YosubShin/head-cam-umi/paper/README.md

# A Head Camera Is (Almost) All You Need — paper sources

Reader's guide for the paper (`main.tex`, built `main.pdf`), as submitted to arXiv
([arXiv:2610.27622](https://arxiv.org/abs/2610.27622), October 2026) and to the CoRL 2026 workshop "The UMI Arena" (Track 3 contributed papers, 2-4 pages excluding
references, CoRL format). The submitted state is tagged `arxiv-v1-submission` in the
[yam-umi](https://github.com/YosubShin/yam-umi) repository, where the draft was written.

Build: `latexmk -pdf main.tex` in this directory (then `latexmk -c`). Layout: `sections/` are the 4-page
versions, `sections/appendix.tex` follows the references, `sections/full/` holds the pre-cut text.
Figure scripts in `fig/` read `../../rollout_logs/grid_20261016/` and `../../docs/results/` of this
repository; `fig/grid_stats.py` reproduces every rollout number in the text.

## The system in five lines

1. The glove is the fiducial-tracked YAM gripper replica from the YAM-UMI paper ([yam-umi/paper](https://github.com/YosubShin/yam-umi/tree/main/paper)).
2. The collector wears one 4K camera. It sees the fiducial ball on the glove, the jaw tags, and
   four printed AprilTag tiles taped around the workspace. Every frame gives camera pose (tiles),
   gripper pose (ball) and jaw width (tags) from that one image. No fixed camera, no IMU, no SLAM.
3. On the robot a six-joint SO-101 arm carries the same camera and keeps the gripper in view the
   way the collector's head kept the hand in view, from the robot's joint state alone. Teleop data
   and rollouts both go through it, so training and deployment share one viewpoint distribution.
4. A fixed external camera exists in the rig only as an ablation (it is how the device-track paper
   labelled the glove).
5. Policies are ACT, one recipe, joint-space actions, best checkpoint by validation loss on 6
   held-out teleoperated episodes.

## The eight policies on the robot

Every arm's teleop half carries the robot's encoder labels; only the glove half carries the
camera under test. Same 198 glove demonstrations in every mix. "val" = ACT loss on the 6
held-out teleoperated episodes, encoder targets, comparable across all rows.

| # | arm (code name) | what it is | glove labels | policy camera | training data | val |
|---|---|---|---|---|---|---|
| 1 | head_Hgt | teleop only, full budget | - | head cam | 172 teleop | 0.318 |
| 2 | mix_gHs3 | **the device** | head cam | head cam | 172 teleop + 194 glove segments | **0.263** |
| 3 | head_Hgt48 | teleop only, low budget | - | head cam | 48 teleop | 0.464 |
| 4 | mix_gHs3_48 | device, low budget | head cam | head cam | 48 teleop + 194 glove | 0.295 |
| 5 | mix_FA | conventional wrist-cam UMI | fixed cam | wrist fisheye | 168 teleop + 253 glove | 0.257 |
| 6 | head_HH | teleop labelled by the head cam, no encoders | - | head cam | 172 teleop | 0.328 |
| 7 | mix_FB | fixed camera as the whole system | fixed cam | fixed cam | 172 teleop + 255 glove | 0.256 |
| 8 | mix_gHA | head labels on the wrist view | head cam | wrist fisheye | 168 teleop + 192 glove | 0.252 |

Notes. Arms 5 and 8 have 168 teleop episodes because the wrist recording has gaps in four.
Arms 5 and 7 have more glove *segments* but 10% fewer glove *frames* (43.5k vs 48.5k): the fixed
camera loses the gripper behind the collector's body, those stretches are cut, and the episodes
fragment. Arm 6 is scored on the encoder targets too (its own-chain loss is 0.282).

## Final rollout tally (25 scenes, 200 trials, done 21:40 on 16 Oct; `fig/grid_stats.py` recomputes)

Protocol: 25 block placements, each placed once and then re-placed to a saved reference image
(ghost alignment) for every other arm; arm order shuffled per scene; 60 s budget; outcome scored
by the operator (success / no grasp / dropped before bin / dropped at bin / timeout).
Log: `rollout_logs/grid_20261016/trials.jsonl`; policy-view mp4 per trial, external-view
`_world.mp4` from scene 15 on.

| # | arm | success | median time to success | failures |
|---|---|---|---|---|
| 1 | teleop only 172 | 18/25 | 16.1 s | 5 no-grasp, 1 dropped before bin (scene 22, slip right after lift), 1 timeout |
| 2 | **device** 172 + glove | **20/25** | 17.4 s | 5 no-grasp |
| 3 | teleop only 48 | 10/25 | 17.2 s | 15 no-grasp |
| 4 | device 48 + glove | 17/25 | 17.2 s | 8 no-grasp |
| 5 | wrist-cam UMI | 15/25 | 18.1 s | 6 no-grasp, 3 dropped before bin, 1 at bin |
| 6 | head-cam teleop labels | 15/25 | 18.7 s | 10 no-grasp |
| 7 | fixed camera system | 12/25 | 18.5 s | 12 no-grasp, 1 dropped at bin |
| 8 | head labels, wrist view | 14/25 | 15.6 s | 3 no-grasp, 7 dropped before bin, 1 at bin |

Paired (same scenes) exact McNemar tests, wins / losses / two-sided p:

| comparison | wins / losses | p |
|---|---|---|
| device 48 vs teleop-only 48 (arm 4 vs 3) | 9 / 2 | 0.065 |
| teleop-only 172 vs 48 (1 vs 3) | 11 / 3 | 0.057 |
| device vs teleop-only, full budget (2 vs 1) | 4 / 2 | 0.69 |
| device 48 vs teleop-only 172 (4 vs 1) | 4 / 5 | 1.0 |
| head labels vs encoders (6 vs 1) | 5 / 8 | 0.58 |
| device vs wrist-cam UMI (2 vs 5) | 6 / 1 | 0.125 |
| device vs fixed camera (2 vs 7) | 11 / 3 | 0.057 |
| device vs head labels on wrist view (2 vs 8) | 8 / 2 | 0.11 |
| label source on the wrist view (8 vs 5) | 2 / 3 | 1.0 |
| wrist vs fixed (5 vs 7) | 9 / 6 | 0.61 |

Drops (before or at bin): wrist-view arms 5+8: 12 of 21 failures; head-view arms 1-4, 6: 1 of 45;
fixed camera: 1 of 13.

Resolution: at 25 trials the binomial 95% interval is about +/-18 points. No pair clears p = 0.05;
the two at 0.06 (budget pair, device vs fixed camera) were at 0.07 with 19 scenes and the wrist pair
went from 6/0 (p = 0.03) to 6/1 (p = 0.125) when arm 5 won scene 24. The paper says so in the
limitations and leans on the consistency of the ranking (arm 2 loses to no arm on more than three
placements) rather than on any one p.

## The one-line story

The provocative version: a head camera is all a UMI needs. The defensible version: one egocentric
moving camera replaces the wrist camera *and* the pose tracker (SLAM, IMU, VR controller, fixed
base camera), and the policy is as good. What it buys: no electronics in the glove at all, since
fiducials give pose and jaw width from the head cam's view. What it costs: a moving camera at
deployment. The mitigation: a cheap servo-driven printed camera arm (SO-101 follower, about $120 in parts; glove $22, camera $122) was shown to work, and its
viewpoint model is a naive linear fit on one glove session, so the numbers here are a floor.

## The stories, in the order the paper tells them

1. **One worn camera labels the glove in the wild.** Tiles replace the fixed camera as the world
   frame; single-tile frames are chained; blind stretches are cut rather than losing the episode.
   Numbers (final): 0.7-7.4% of frames cut per session vs 8-22% for the fixed camera; tool-point
   label error vs the robot's encoders 6.5 mm median / 14.1 mm p90, 1.55 deg; a policy trained on
   head-cam labels instead of encoders pays 3% in validation loss (0.328 vs 0.318), where the
   fixed-camera glove paid 14% in the device paper.
2. **Glove data stretches a small teleop budget.** Offline: the 194 glove segments are worth
   65-100 teleop episodes (2-3 glove demos per teleop demo); 48 teleop + glove lands between 96
   and 172 teleop alone. Robot (final, 25 scenes): 10/25 -> 17/25 at the 48 budget (9 wins / 2 losses, p = 0.065),
   level with the full 172-episode teleop-only arm (18/25); every failure of both 48-episode arms a no-grasp. The gain shrinks with budget: at full budget the device and teleop-only are
   tied (20/25 vs 18/25), which is the task ceiling (about 80%), not a failure of the glove data.
3. **The same camera on the robot closes the viewpoint gap.** Teleop and rollouts see what the
   collector saw. The positioner is driven from joint state only, identically in both.
4. **Which camera, and why.** Offline all four co-trained arms (2, 5, 7, 8) are within 0.011, so
   the loss does not separate cameras. On the robot the failure modes do: head-view arms fail
   by never grasping (43 of 45 failures; one slip right after lift, one timeout); wrist-view arms
   drop the block during the carry (12 of 21), and every observed wrist drop happened while the
   bin was outside the fisheye's view. Arm 8 vs 2 isolates the observation
   (same labels); arm 8 vs 5 isolates the label source (same observation); arm 7 asks whether a
   moving camera is needed at all.

## What the paper now claims (25 scenes, all filled in; `\grid` renders black now)

- Glove data recovers the low-budget teleop policy (arm 4 vs 3: 17/25 vs 10/25, 9 wins to 2,
  p = 0.065) and lands it level with the full-budget teleop-only arm (18/25). Headline robot
  result; matches the offline curve. Written as "outperforming ... matching".
- At full budget co-training does no harm (arm 2 vs 1: 20/25 vs 18/25, 4/2). Task ceiling about
  80%.
- The camera matters, the labels do not. Device 20/25 vs wrist 15/25, fixed 12/25, head labels on
  wrist 14/25 (6/1, 11/3, 8/2 wins). Same labels, wrist view (8 vs 2): loses six placements and
  the no-grasps become drops. Same view, other labels (8 vs 5): 14 vs 15, 2/3, indistinguishable.
- Failure modes split by camera: 12 of 21 wrist-view failures are drops; 1 of 45 head-view
  failures (a slip, not a release); the fixed camera fails like the head view (no grasp) but more
  often.
- Head-camera labels in place of encoders: 15/25 vs 18/25, 5 wins to 8, p = 0.58. Written as
  "within the noise of 25 trials", not "as good as".
- Honesty line in the limitations: single seed, one trial per placement, no pair below 0.05, two
  at 0.06, ranking consistent.

## What is still open in the text

- Teaser figure: done (`fig/make_teaser.py`; sources `fig/src/collector_iphone_26s.jpg`, `rollout_iphone_250s.jpg`,
  `headcam_glove6_182s_overlay.jpg`). The iPhone videos they come from are in `media/originals/` (gitignored)
  and on the NAS at `yam-umi-media/originals/`; the rollout one (8 min, all arms on one scene) is supplementary-video material.
- Two `\todo{confirm}` in limitations (one collector; remote-workspace calibration), how the camera
  is worn (system), which hand-eye solver (system), keep-or-cut on fig:rollouts.
- Length: cut to 4 pages of body at 22:50 on 16 Oct (references on p.5, appendix A-C with the budget curve,
  placements map and rollout strip on p.7-8). The full-length sections are kept in `sections/full/` for
  reference and for the camera-ready; nothing was deleted, only moved to the appendix or condensed.

## Caveats to keep in the text

- The fixed camera was mounted low because the positioner occupied the high vantage point; its
  occlusion rate (8-22%) is an upper bound for a fixed camera in this workspace. Arm 8 is the
  control that does not depend on the mount height.
- Tile layout was refit from one session by median single-tile poses, not bundle-adjusted.
- Positioner lag about 0.4 s; joint limits on the largest sweeps.
- Appearance gap: the head cam sees the collector's arm and the glove's fingers; glove-only
  policies do not transfer (val 0.52 vs 0.26 co-trained), as in the device paper.
- 25 trials per arm; one seed per policy; no paired difference below p = 0.05 (two at 0.06).

## Anecdotes (operator notes, `rollout_logs/grid_20261016/anecdotes.md`)

- Scene 5, low budget: teleop-only could not close in on the block; the mix missed its first
  grasp, backed off, re-grasped and succeeded.
- Scene 5, arm 8: opened the gripper mid-carry with the block out of the wrist camera's view.
- Wrist-view arms drop when the wrist view is looking away from the bin; the converse was never
  seen.

## Feedback received so far

**Yuan (16 Oct, after reading the draft and setting up collection on a Mac).**

1. *Jaw-width accuracy deserves its own check.* Their fixed-camera width estimator read a
   59.1 mm opening with 0.29 mm p95 error in one view but 2.3 and 5.1 mm in two turned poses.
   Done: a width sentence in the label-accuracy paragraph, from the 112 teleoperated episodes
   where encoders are the reference (3.5% of stroke median, 7.9% p90, 2.3% when closed, no lag,
   100% coverage in 9 of 10 episodes, a 4-6% under-read at full opening). Also binned by workspace quartile, distance, camera elevation and
   line-of-sight angle to the jaws (forward kinematics on the encoder joints): every bin 2.8-4.8%
   median, 6.8-8.5% p90, worst looking across the jaws. The fixed camera of the device paper read
   the same gripper at 4.4% median, 94% coverage. What this does not cover: openings never seen in
   calibration (the teleop estimators are fit on alternate frames of the same session; the glove's
   are fit on spacer holds in one session and applied to the other three, unmeasured).
2. *Tile placement and visibility.* Clips where the head cam tracked the glove but got no world
   pose; a tag PDF open on a laptop confused localisation. Done: two practical rules in the
   collection paragraph (tiles where the gaze lands at the grasp, two in view from the natural head
   pose, none under the bin or in the arm's sweep; no other tag in the scene).

**Yosub.** The tail was not explained; it is now (collection paragraph). It is the part that makes
an electronics-free glove possible: fingertip tags face the wrist camera and are invisible from
behind the hand (0 of 13.7k frames in the first test, Aug 2026), so each jaw carries a wedge with
tags on five faces, read against a fixed tag on the gripper back. The original feasibility
numbers (robot gripper, fixed camera, Aug-Sep 2026): single-tail fallback 5-7 mm RMS over the
95 mm swing; later wedges with more faces, 94% coverage and 4.4% of stroke median error.

## Confound to keep in mind (not in the paper)

Between last week's rollouts and this grid the glove width map changed (closed-on-object anchor
0.246 -> 0.225, the squeeze level). Last week's mid-air drops, including the wrist and fixed-cam
arms, cannot be attributed to the camera because of that; this grid is clean (all eight arms use
the new map), and within it the head-view arms have not dropped once. Grasp tuning is necessary
regardless of camera.

## Hypothesis to keep in view: the teleoperation style is the head view's

All eight arms train on the same 172 teleoperated episodes, recorded by the head, wrist and fixed
cameras at once, so the actions are identical across arms and only the observation differs. Those
actions were chosen by an operator watching the head camera's preview. Nothing in them keeps the
bin inside the fisheye's view during the carry, or keeps the gripper clear of the robot's own upper
arm for the low fixed camera. Rollout frames (scene 12) show exactly that: from the grasp onward
the wrist view holds the block and the far wall and nothing else, the bin appearing only at the
end; the head view holds bin, gripper and block throughout; the fixed view loses the gripper behind
the upper arm. Every policy inherits the style, and the two cameras that do not share the
operator's view pay at those moments (wrist: drops; fixed: no-grasp from occlusion).

This is also the normal UMI condition, since a human demonstrator sees the scene while the wrist
camera sees a cone, so it is a property of the method rather than a handicap we introduced. The
defensible claim is "the camera that shares the demonstrator's view wins".

The two sentences are in the text (design paragraph; limitations).

Future work, actual experiments:

- With existing data: over the carry phase of the 172 teleoperated episodes, the fraction of
  frames in which the bin is inside each camera's view (large grey-blue region, area threshold
  separates it from the small blue blocks), from the three synchronized streams.
- New collection: a teleop set recorded under a wrist-camera preview (and one under the fixed
  camera's), same episode budget, then arms 5 and 7 retrained on it. This separates "better
  camera" from "camera that matches the demonstrator".

## Where help is wanted (Igor)

- Citations and one or two background sentences in Section 1: SLAM/IMU tracking in UMI-style
  devices vs fiducial or marker-based localisation; prior work that moves a robot-side camera to
  match a human viewpoint (active perception, head-mounted or arm-mounted cameras); the
  egocentric viewpoint gap literature. No related-work section is planned; clauses in place.
- Tone of the limitations paragraph and the "what is next" sentence.
- Anything in the system section that is unclear to a reader who has not seen the rig.
- The red `\todo` items: how the camera is worn (mount, weight), teaser figure, placements figure.

Repository layout: `main.tex` (preamble, title, teaser figure, bibliography) pulls in one file per
section from `sections/` (`abstract`, `idea`, `system`, `experiments`, `limitations`), so edit the
text there. `resources/venue.md` records the venue rules and dates. `refs.bib` (shared with the
device paper), `fig/make_budget.py`
regenerates `fig/budget.pdf` from `../docs/results/head_val_curves.csv`. The YAM-UMI paper (yam-umi/paper) is
the reference for style and length.
