YosubShin/head-cam-umi/paper/main.tex

\documentclass{article}

% CoRL 2026 workshop "The UMI Arena", Track 3 (contributed papers): 2-4 pages EXCLUDING acknowledgements
% and references, CoRL main-conference format, single-blind, OpenReview. Topics hit: in-the-wild tracking
% beyond SLAM; the egocentric viewpoint gap between collection and deployment; data scaling/curation.
% Full venue rules and dates: resources/venue.md. Body text lives in sections/*.tex.
\usepackage[preprint]{corl_2026}
\usepackage{graphicx}
\usepackage{booktabs}
\usepackage{xcolor}
\usepackage{siunitx}
\usepackage{multirow}
\newcommand{\todo}[1]{\textcolor{red}{[#1]}}
\newcommand{\grid}[1]{#1}   % numbers from the 2026-10-16 rollout grid (final, 25 scenes; fig/grid_stats.py). Was blue while unfilled.

\title{A Head Camera Is (Almost) All You Need:\\An Electronics-Free UMI Glove Labelled and Observed by One Moving Camera}

\author{
  Yosub Shin \\
  University of Hawaii at Manoa \\
  \texttt{yosubs@hawaii.edu} \\
  \And
  Yuan Liu \\
  Independent \\
  \texttt{hiveyuan@gmail.com} \\
  \And
  Igor Molybog \\
  University of Hawaii at Manoa \\
  \texttt{molybog@hawaii.edu} \\
}

\begin{document}
\maketitle

%===============================================================================
\input{sections/abstract}

\begin{figure}[!h]
  \centering
  
  \caption{One camera, two mounts. (a) The collector wears the camera and holds the electronics-free glove over the tiled workspace. (b) The camera's own frame: tiles (green), ball (red) and jaw tags (blue, yellow) give the pose and the jaw width. (c) The same camera on a six-joint positioner beside the robot during a rollout. The wrist fisheye on the glove and the fixed camera on the post serve the ablations only.}
  \label{fig:teaser}
\end{figure}

%===============================================================================
\input{sections/idea}

%===============================================================================
\input{sections/system}

%===============================================================================
\input{sections/experiments}

%===============================================================================
\input{sections/limitations}

%===============================================================================
\bibliography{refs}

%===============================================================================
\input{sections/appendix}

\end{document}
