YosubShin/head-cam-umi/paper/poster/poster.tex

% UMI Arena (CoRL 2026) poster, 48 x 36 in landscape. Build: latexmk -pdf poster.tex
\documentclass[final]{beamer}
\usepackage[orientation=landscape,size=custom,width=121.92,height=91.44,scale=1.3]{beamerposter}
\usepackage[T1]{fontenc}\usepackage[scaled=0.95]{helvet}\renewcommand{\familydefault}{\sfdefault}
\usepackage{booktabs,siunitx,qrcode,tikz,graphicx,ragged2e,colortbl}
\graphicspath{{../fig/}}

% ---------- theme ----------
\definecolor{ink}{HTML}{1E2A38}
\definecolor{navy}{HTML}{16324F}
\definecolor{teal}{HTML}{2A7F8F}
\definecolor{amber}{HTML}{D9822B}
\definecolor{paper}{HTML}{FBFAF7}
\definecolor{panel}{HTML}{FFFFFF}
\definecolor{muted}{HTML}{5C6670}
\definecolor{nograsp}{HTML}{B8B2A7}
\setbeamertemplate{navigation symbols}{}
\setbeamercolor{background canvas}{bg=paper}
\setbeamercolor{normal text}{fg=ink}
\setbeamercolor{block title}{fg=navy,bg=panel}
\setbeamercolor{block body}{fg=ink,bg=panel}
\setbeamerfont{block title}{size=\Large,series=\bfseries}
\setbeamertemplate{block begin}{%
  \begin{beamercolorbox}[colsep*=0.4ex,dp=0.6ex,leftskip=1.2em,rightskip=1.2em]{block title}%
    \usebeamerfont{block title}\insertblocktitle\par
    \vskip-0.4ex\textcolor{teal}{\rule{\bw}{2.5pt}}%
  \end{beamercolorbox}%
  \begin{beamercolorbox}[colsep*=0.4ex,vmode,leftskip=1.2em,rightskip=1.2em]{block body}\RaggedRight}
\setbeamertemplate{block end}{\vskip0.8ex\end{beamercolorbox}\vskip1.4ex}
\setbeamertemplate{itemize item}{\color{teal}\raisebox{0.15ex}{\rule{0.55em}{0.55em}}}
\setlength{\parskip}{0.7ex}
\setlength{\leftmargini}{1.4em}
\newcommand{\bw}{\dimexpr\linewidth-2.4em\relax}
\newcommand{\key}[1]{\textbf{\color{navy}#1}}
\newcommand{\bignum}[2]{\begin{minipage}[t]{#1}\centering{\fontsize{66}{70}\selectfont\bfseries\color{amber}#2}\end{minipage}}
\newcommand{\numlabel}[2]{\begin{minipage}[t]{#1}\centering\small\color{muted}#2\end{minipage}}
\newcommand{\capt}[1]{{\small\color{muted}#1\par}}

\begin{document}
\begin{frame}[t]
\vspace*{-1.4cm}
% ---------- header ----------
\begin{tikzpicture}[overlay,remember picture]
  \fill[navy] (current page.north west) rectangle ([yshift=-12.0cm]current page.north east);
\end{tikzpicture}
\noindent\parbox[t][10.0cm][c]{\linewidth}{%
\begin{columns}[c,totalwidth=\linewidth]
\begin{column}{0.80\linewidth}
  \hspace*{2.4cm}\begin{minipage}{0.95\linewidth}
  {\fontsize{76}{82}\selectfont\bfseries\color{white}A Head Camera Is (Almost) All You Need\par}
  \vspace{0.5cm}
  {\fontsize{40}{46}\selectfont\color{white!85!navy}An electronics-free UMI glove labelled and observed by one moving camera\par}
  \vspace{0.8cm}
  {\fontsize{32}{36}\selectfont\color{white}Yosub Shin$^{1}$ \quad Yuan Liu$^{2}$ \quad Igor Molybog$^{1}$\hspace{2.5cm}
   {\fontsize{26}{30}\selectfont\color{white!80!navy}$^1$University of Hawai\textquotesingle i at M\=anoa \quad $^2$Independent}\par}
  \end{minipage}
\end{column}
\begin{column}{0.20\linewidth}
  \centering
  \colorbox{white}{\qrcode[height=6.6cm]{https://github.com/YosubShin/head-cam-umi}}\par
  \vspace{0.3cm}{\small\color{white}github.com/YosubShin/head-cam-umi}\par{\small\color{white!80!navy}arXiv:2610.27622\par The UMI Arena, CoRL 2026}
\end{column}
\end{columns}}
\vspace{0.5cm}

% ---------- body ----------
\begin{columns}[t,totalwidth=0.975\paperwidth]

% ===== left two thirds =====
\begin{column}{0.655\linewidth}

\begin{columns}[t,totalwidth=\linewidth]
\begin{column}{0.3\linewidth}
\begin{block}{Why a head camera only}
  \begin{itemize}\setlength{\itemsep}{0.9ex}
    \item \key{What the operator sees is what the policy sees}: no privileged observation that only the human had.
    \item \key{No synchronization}: one frame is the observation and carries all three labels: camera pose, gripper pose, jaw opening. No cameras, IMUs or encoders to align.
    \item \key{Electronics-free glove}: cheap, robust, and scalable.
  \end{itemize}
  \vspace{2.6ex}
  \begin{center}
  \bignum{0.48\linewidth}{\$22}\bignum{0.48\linewidth}{370\,g}\\[0.3ex]
  \numlabel{0.48\linewidth}{glove, printed}\numlabel{0.48\linewidth}{on the hand; UMI 780\,g}\\[3.2ex]
  \bignum{0.48\linewidth}{\$122}\bignum{0.48\linewidth}{103\,g}\\[0.3ex]
  \numlabel{0.48\linewidth}{head camera}\numlabel{0.48\linewidth}{on the head}
  \end{center}
  \vspace{4ex}
\end{block}
\end{column}
\begin{column}{0.7\linewidth}
\begin{block}{One head camera: the policy\textquotesingle s observation and the pose labels}
  \centering
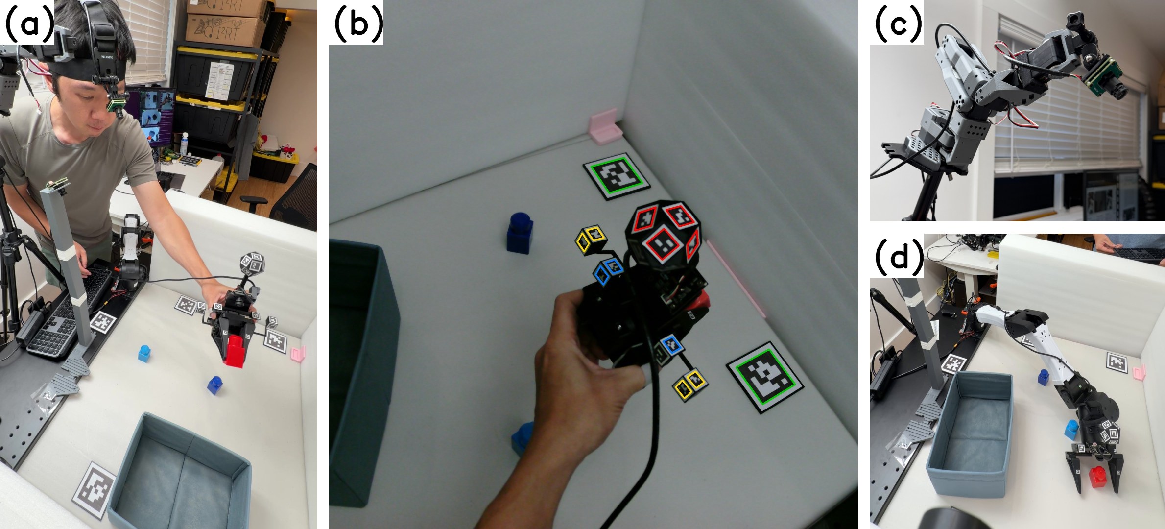
[picture p5: paper/fig/teaser_poster.jpg]
  \par
  \vspace{0.4ex}
  \begin{minipage}{\bw}\capt{(a) A \$122 4K head camera, a \$22 electronics-free glove, four paper tiles.
  (b) The camera's own frame: tiles give the camera pose, the ball the gripper pose, the jaw tags the opening.
  (c) At deployment the same camera rides a \$122 six-joint arm (d) beside the robot.}\end{minipage}
\end{block}
\end{column}
\end{columns}

\begin{columns}[t,totalwidth=\linewidth]
\begin{column}{0.325\linewidth}
\begin{block}{Label accuracy}
  \begin{itemize}
    \item \key{Camera pose} from the paper tiles.
    \item \key{Gripper pose} from ArUco tags on a dodecahedron ball.
    \item \key{Jaw width} from printed tails on the jaws.
  \end{itemize}
  \vspace{0.3ex}
  \begin{center}
  \bignum{0.31\linewidth}{6.5\,mm}\bignum{0.31\linewidth}{1.6\textdegree}\bignum{0.34\linewidth}{3.5\,\%}\\[0.3ex]
  \numlabel{0.31\linewidth}{tool point}\numlabel{0.31\linewidth}{orientation}\numlabel{0.34\linewidth}{jaw width, of stroke}
  \end{center}
  \capt{Median error against the robot's encoders; a label on 93--100\,\% of frames.}
  \vspace{1.1ex}
\end{block}
\end{column}

\begin{column}{0.325\linewidth}
\begin{block}{Collection}
  \begin{itemize}
    \item \key{The operator wears the head camera}; the glove has no wrist camera, IMU or encoder.
    \item \key{No special protocol}, such as keeping the wrist facing the bin: what the operator sees is what the policy sees.
  \end{itemize}
  \vspace{0.3ex}
  \begin{center}
  \bignum{0.48\linewidth}{2--3$\times$}\bignum{0.48\linewidth}{6--8\,s}\\[0.3ex]
  \numlabel{0.48\linewidth}{demos per minute vs teleop}\numlabel{0.48\linewidth}{per demo; teleop 14\,s}
  \end{center}
  \capt{Continuous recording, episodes cut by a keypress.}
\end{block}
\end{column}

\begin{column}{0.325\linewidth}
\begin{block}{Deployment}
  \begin{itemize}
    \item \key{Same 4K camera on a modified SO-101 arm}: gripper joint replaced by the camera; \$122 in parts.
    \item \key{A simple linear model} of the collector's head motion relative to the gripper drives it from the robot's encoders alone.
    \item \key{No wrist camera} necessary.
  \end{itemize}
  \vspace{0.3ex}
  \begin{center}
  \bignum{0.48\linewidth}{46\,mm}\bignum{0.48\linewidth}{5.4\textdegree}\\[0.3ex]
  \numlabel{0.48\linewidth}{head pose vs the collector}\numlabel{0.48\linewidth}{static camera: \SI{87}{mm}, \SI{7.0}{\degree}}
  \end{center}
\end{block}
\end{column}
\end{columns}

\begin{block}{One placement, seen by each policy}
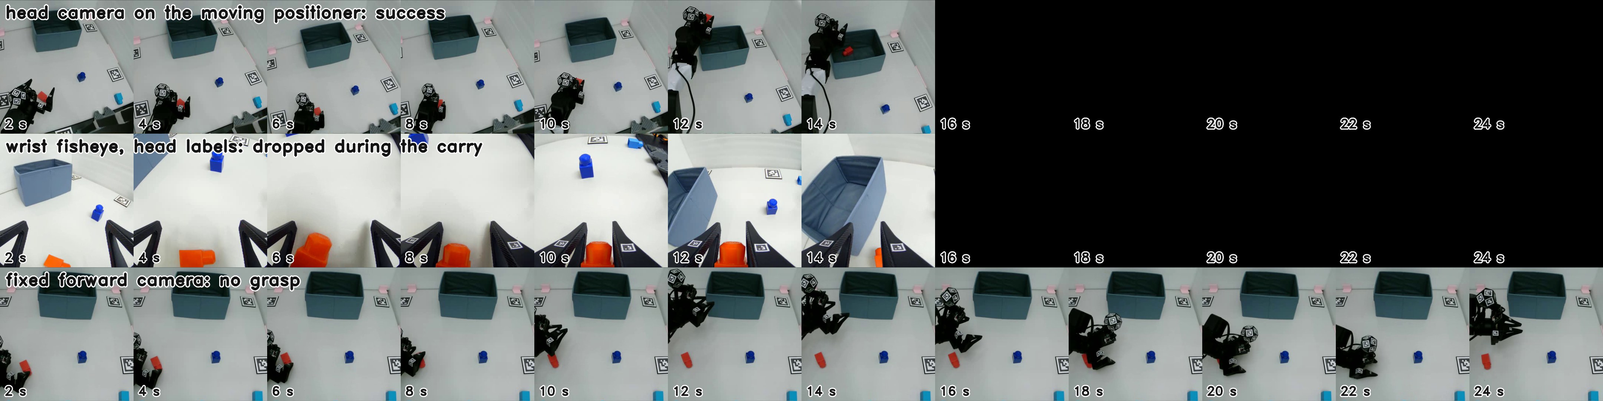
[picture p6: paper/fig/rollouts_poster.jpg]
  \par
  \capt{Placement 23, each policy's own frames every \SI{2}{s} on one clock, black once its episode ended. Head camera: gripper and bin in one frame through the carry, done in \SI{16}{s}. Wrist fisheye: only block and wall after the grasp; drops the block before reaching the bin. Fixed camera: sees the whole scene but never closes the gripper (\SI{41}{s}, cut here).}
\end{block}

\end{column}

% ===== right third: results =====
\begin{column}{0.335\linewidth}
\begin{block}{Cheap glove demos complement a small teleop set}
  \begin{minipage}[c]{0.45\linewidth}\end{minipage}\hfill
  \begin{minipage}[c]{0.45\linewidth}\centering
    \bignum{\linewidth}{10/25}\\[0.2ex]\numlabel{\linewidth}{48 teleop episodes}\\[0.9ex]
    \bignum{\linewidth}{17/25}\\[0.2ex]\numlabel{\linewidth}{48 teleop + 194 glove demos}\\[0.9ex]
    \bignum{\linewidth}{1 $\approx$ 2--3}\\[0.2ex]\numlabel{\linewidth}{teleop episode $\approx$ glove demos}
  \end{minipage}
  \vspace{0.8ex}

  9 placements won to 2 lost ($p = 0.065$). On the curve (head-label chain, own held-out targets) the 194 glove demos are worth \key{65--100 teleop episodes}. With all 172 they still help: 18/25 $\to$ 20/25 (4 won to 2 lost, $p = 0.69$).
\end{block}

\begin{block}{Head-camera labels can replace the encoders}
  \begin{center}\normalsize
  \setlength{\tabcolsep}{0pt}\renewcommand{\arraystretch}{1.1}
  \begin{tabular*}{\bw}{@{\extracolsep{\fill}}lcl@{}}
    \toprule
    \textbf{teleop labelled by} & \textbf{encoders} & \textbf{head camera} \\
    \midrule
    \textbf{validation loss} & 0.318 & 0.328 {\small\color{muted}(+3\,\%)} \\
    \textbf{rollouts} & 18/25 & 15/25 {\small\color{muted}($p = 0.58$)} \\
    \bottomrule
  \end{tabular*}
  \end{center}
  Same 172 teleop episodes, same held-out encoder targets; 5 placements won to 8 lost ($p = 0.58$).
\end{block}

\begin{block}{Where each view fails}
  \begin{center}\normalsize
  \setlength{\tabcolsep}{0pt}\renewcommand{\arraystretch}{1.1}
  \begin{tabular*}{\bw}{@{\extracolsep{\fill}}lccc@{}}
    \toprule
    \textbf{failures of 25} & \textbf{no grasp} & \textbf{dropped} & \textbf{\color{muted}success} \\
    \midrule
    \textbf{head camera} & \textbf{5} & 0 & \color{muted}20 \\
    \textbf{wrist fisheye (UMI)} & 6 & \textbf{4} & \color{muted}15 \\
    \textbf{wrist fisheye, head labels} & 3 & \textbf{8} & \color{muted}14 \\
    \textbf{fixed camera} & \textbf{12} & 1 & \color{muted}12 \\
    \bottomrule
  \end{tabular*}
  \end{center}
  Wrist policies \key{drop the block mid-carry}, always while the fisheye looks away from the bin. Head and fixed cameras keep the bin in frame and fail only by not grasping.
\end{block}

\begin{block}{It is the view, not the labels}
  \setlength{\tabcolsep}{2pt}\renewcommand{\arraystretch}{1.1}
  \begin{minipage}[t]{0.47\bw}\centering
    \textbf{Same view, other labels}\\[0.2ex]
    {\small\color{muted}wrist fisheye observation}\\[0.1ex]
    \begin{tabular*}{\linewidth}{@{\extracolsep{\fill}}lcc@{}}
      \toprule
      \textbf{labels from} & \textbf{success} & \textbf{dropped} \\
      \midrule
      \textbf{fixed camera} & 15/25 & 4 \\
      \textbf{head camera} & 14/25 & 8 \\
      \bottomrule
    \end{tabular*}
  \end{minipage}\hfill
  \begin{minipage}[t]{0.47\bw}\centering
    \textbf{Same labels, other view}\\[0.2ex]
    {\small\color{muted}head-camera glove labels}\\[0.1ex]
    \begin{tabular*}{\linewidth}{@{\extracolsep{\fill}}lcc@{}}
      \toprule
      \textbf{observation} & \textbf{success} & \textbf{dropped} \\
      \midrule
      \textbf{wrist fisheye} & 14/25 & 8 \\
      \textbf{head camera} & \textbf{20/25} & \textbf{0} \\
      \bottomrule
    \end{tabular*}
  \end{minipage}
\end{block}

\begin{block}{Limits and next}
  \newcommand{\li}{\par\hangindent=1.1em\hangafter=1\noindent\textcolor{teal}{\raisebox{0.15ex}{\rule{0.55em}{0.55em}}}\ }
  \begin{minipage}[t]{0.47\bw}\RaggedRight\small
    \textbf{Limits}
    \li One task, one collector, one tile layout.
    \li Teleop watched the head-camera view.
    \li Glove-only policies do not transfer; co-training is required.
  \end{minipage}\hfill
  \begin{minipage}[t]{0.47\bw}\RaggedRight\small
    \textbf{Next}
    \li Precision tasks, e.g.\ cable ties.
    \li Bimanual, with a second glove.
    \li Tile-free sessions in the wild.
  \end{minipage}
\end{block}
\capt{Setup: eight ACT policies, joint-space actions. Rollouts: 25 placements, one trial each, \SI{60}{s}. Every co-trained mix uses the same 194 glove demos.}

\end{column}
\end{columns}
\end{frame}
\end{document}
