YosubShin/head-cam-umi/paper/fig/budget_poster.pdf

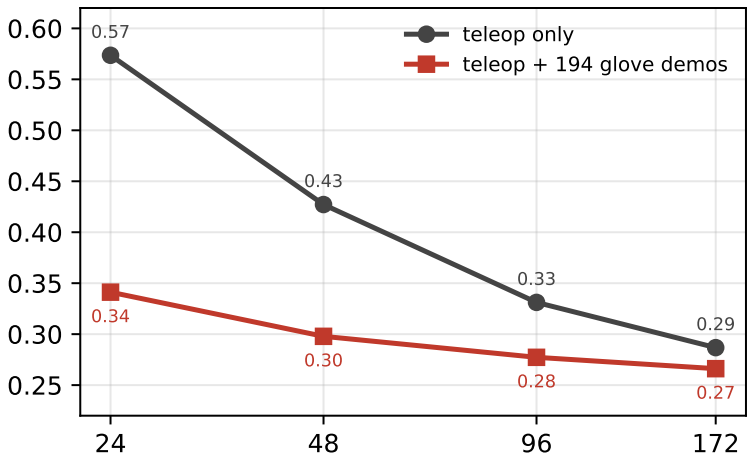
[picture p11: figure]
teleop only; teleop + 194 glove demos

teleoperated episodes in the training set robot val loss (6 held-out eps)
