YosubShin/head-cam-umi/calib/forward_ref_20261012.png

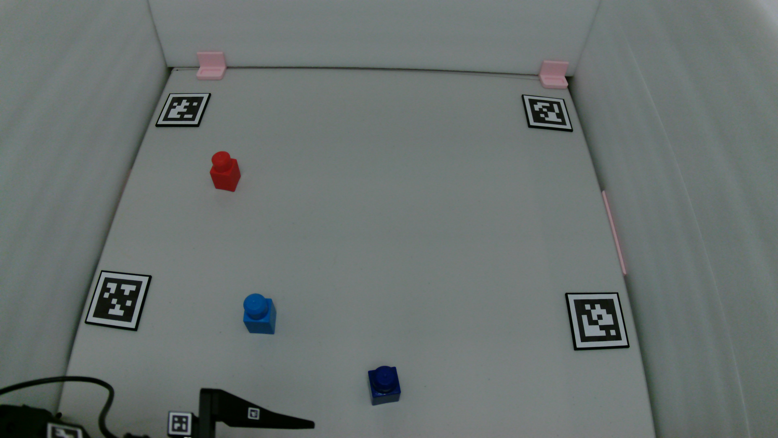
calib/forward_ref_20261012.png
