YosubShin/head-cam-umi/paper/fig/src/positioner_photo_20261110.jpg

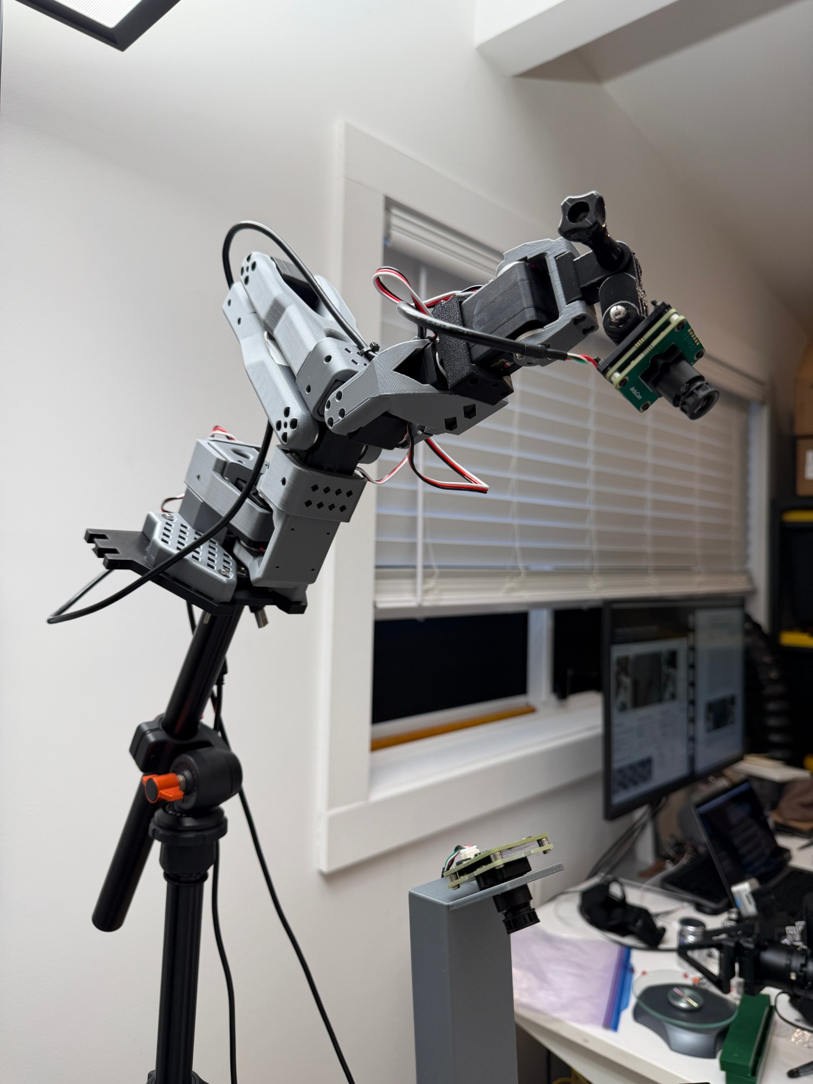
paper/fig/src/positioner_photo_20261110.jpg
