YosubShin/head-cam-umi/paper/fig/src/rollout_iphone_336s.jpg

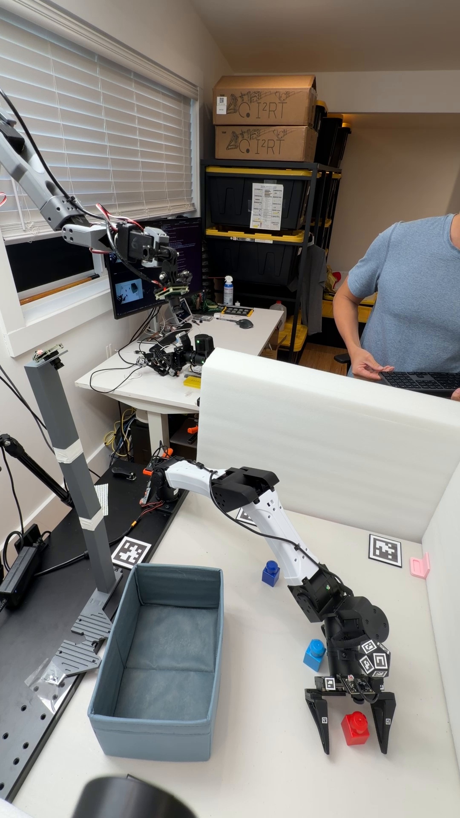
paper/fig/src/rollout_iphone_336s.jpg
