YosubShin/head-cam-umi/STEP/gripper_back_marker_holder.step

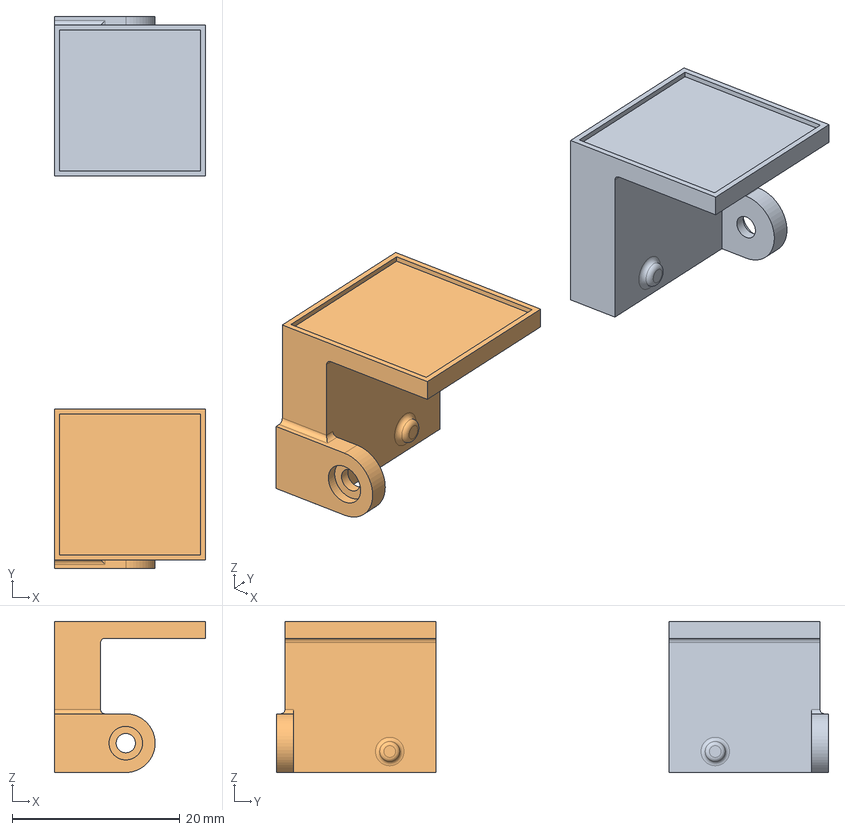
[picture p15: CAD file, 2026-11-13]
STEP/gripper_back_marker_holder.step
18.0 x 65.8 x 18.0 mm
left
right
