YosubShin/head-cam-umi/STL/gripper_back_marker_holder_left.stl

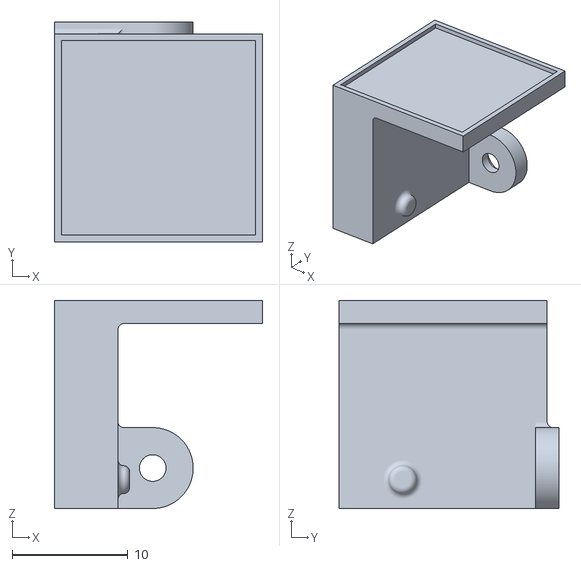
[picture p16: CAD file, 2026-11-13]
STL/gripper_back_marker_holder_left.stl
18.0 x 19.0 x 18.0
