YosubShin/head-cam-umi/STEP/arducam_gopro_mount.step

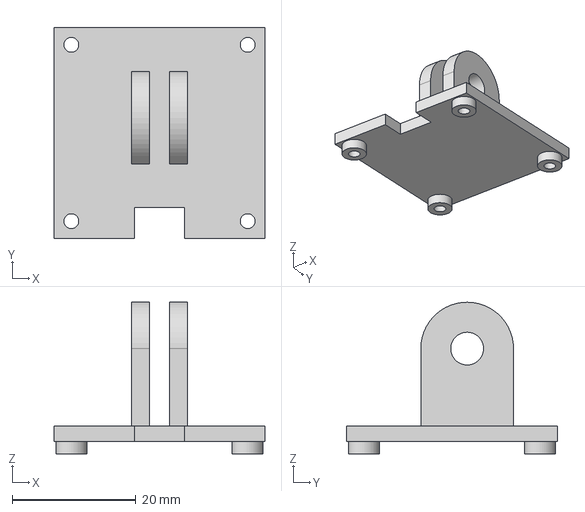
[picture p17: CAD file, 2026-10-25]
STEP/arducam_gopro_mount.step
34.1 x 34.1 x 24.5 mm
