YosubShin/head-cam-umi/STL/wrist_yaw_motor_housing.stl

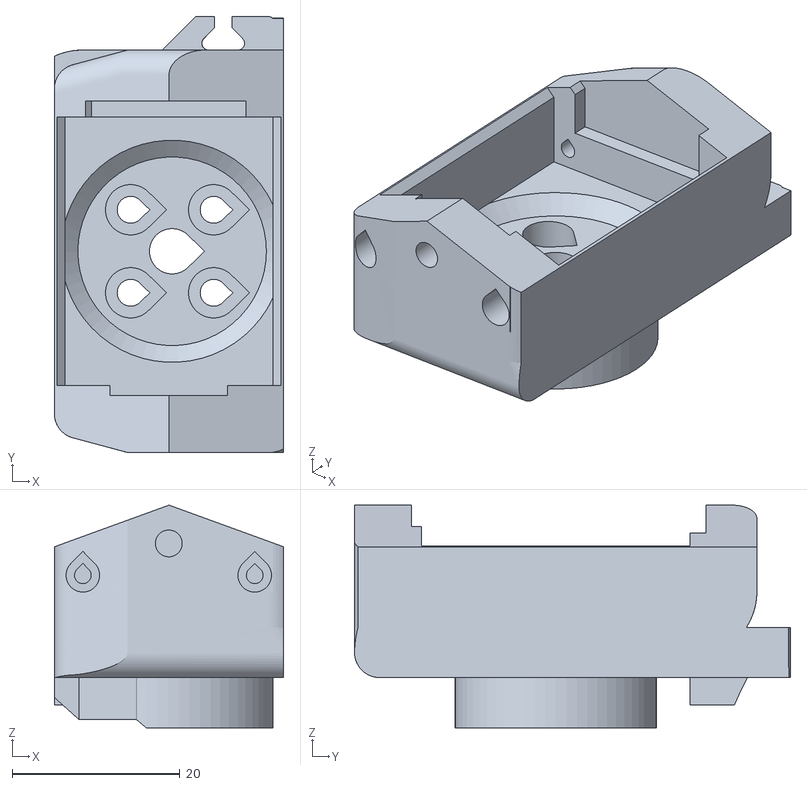
[picture p18: CAD file, 2026-10-25]
STL/wrist_yaw_motor_housing.stl
27.4 x 52.0 x 26.6
