YosubShin/head-cam-umi/STL/finger_mount_to_gopro_mount.stl

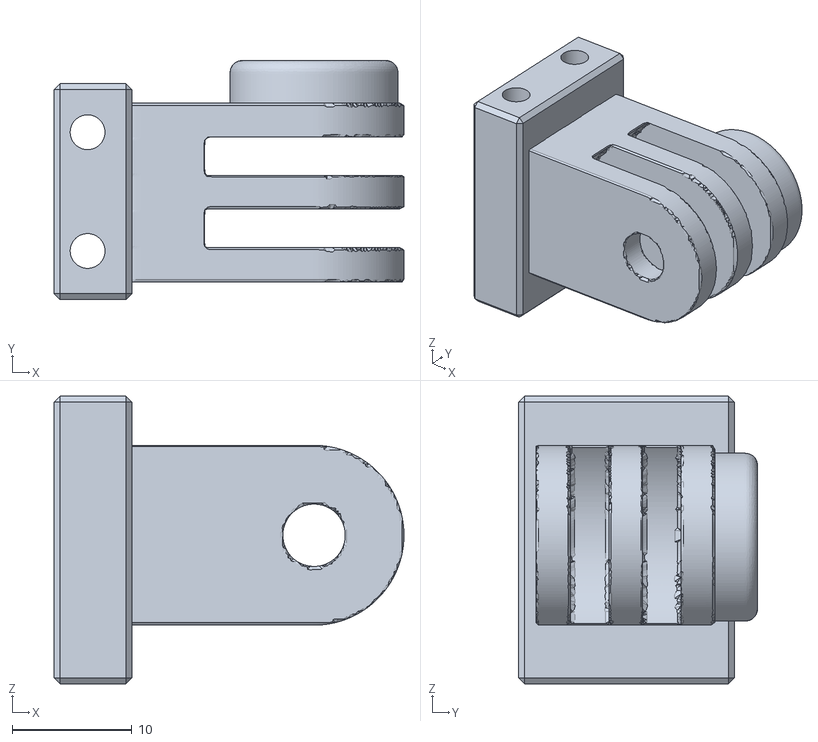
[picture p19: CAD file, 2026-10-25]
STL/finger_mount_to_gopro_mount.stl
29.2 x 19.9 x 24.0
