YosubShin/head-cam-umi/(list of files, cad)

Other CAD files:
STL/gripper_back_marker_holder_right.stl
STL/xlerobot_soft_fin_horn_adapter.stl
STL/arducam_gopro_mount.stl
