YosubShin/head-cam-umi/docs/results/head_val_curves.csv

run | seed | step | val_loss
glove_Hcj_s45_act50@robotval | 1000 | 002000 | 1.628097
glove_Hcj_s45_act50@gloveval | 1000 | 002000 | 1.313724
glove_Hcj_s45_act50@robotval | 1000 | 004000 | 0.972457
glove_Hcj_s45_act50@gloveval | 1000 | 004000 | 0.658270
glove_Hcj_s45_act50@robotval | 1000 | 006000 | 0.731348
glove_Hcj_s45_act50@gloveval | 1000 | 006000 | 0.441336
head_Aj_act50@robotval | 1000 | 002000 | 1.385218
glove_Hcj_s45_act50@robotval | 1000 | 008000 | 0.690377
head_Aj_act50@gloveval | 1000 | 002000 | 1.460225
glove_Hcj_s45_act50@gloveval | 1000 | 008000 | 0.371556
head_Aj_act50@robotval | 1000 | 004000 | 0.729996
glove_Hcj_s45_act50@robotval | 1000 | 010000 | 0.617965
head_Aj_act50@gloveval | 1000 | 004000 | 0.837200
glove_Hcj_s45_act50@gloveval | 1000 | 010000 | 0.339106
head_Aj_act50@robotval | 1000 | 006000 | 0.511125
glove_Hcj_s45_act50@robotval | 1000 | 012000 | 0.591332
head_Aj_act50@gloveval | 1000 | 006000 | 0.618520
mix_hA_act50@robotval | 1000 | 002000 | 1.331611
glove_Hcj_s45_act50@gloveval | 1000 | 012000 | 0.321462
head_Aj_act50@robotval | 1000 | 008000 | 0.432425
glove_Hcj_s45_act50@robotval | 1000 | 014000 | 0.593326
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
