YosubShin/head-cam-umi/docs/results/pilot_glove_HHs3_sources.csv

hhs3_episode | session | stem | mark_episode | status | duration_s | expected_len | len | t_start | t_end
0.0 | 8 | yam_glove8_b0587b | 0 | exact | 5.72 | 215 | 215 | 1792100481.0392869 | 1792100486.7597692
1.0 | 8 | yam_glove8_b0587b | 1 | exact | 5.58 | 210 | 210 | 1792100500.135388 | 1792100505.7137847
2.0 | 8 | yam_glove8_b0587b | 2 | exact | 6.67 | 250 | 250 | 1792100522.5548587 | 1792100529.2210505
3.0 | 8 | yam_glove8_b0587b | 3 | exact | 6.14 | 231 | 231 | 1792100540.3575292 | 1792100546.5014942
4.0 | 7 | yam_glove7_b0587b | 0 | exact | 6.52 | 245 | 245 | 1792097419.2354183 | 1792097425.7546947
5.0 | 7 | yam_glove7_b0587b | 1 | exact | 6.34 | 238 | 238 | 1792097441.48517 | 1792097447.8277133
6.0 | 7 | yam_glove7_b0587b | 2 | trimmed | 5.6 | 210 | 192 | 1792097457.6982574 | 1792097463.2960596
7.0 | 7 | yam_glove7_b0587b | 3 | exact | 5.26 | 198 | 198 | 1792097476.4490883 | 1792097481.7054017
8.0 | 7 | yam_glove7_b0587b | 4 | exact | 6.89 | 259 | 259 | 1792097497.9176614 | 1792097504.8060014
9.0 | 7 | yam_glove7_b0587b | 5 | trimmed | 6.79 | 255 | 102 | 1792097528.533198 | 1792097535.318905
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
