YosubShin/head-cam-umi/(commit log)

2026-10-24 Live body-pose publisher for the head tracker
    labels_lib.solve_body_pose: one frame's fused body pose from 4x4 detections, shared by the offline
    build and the live path. uvc_record: POSE_PUB=<port> solves the unit in view on the half-res preview
    pipe and publishes {t, rvec, tvec, rms, n} over ZMQ. record_session starts it so so101_cam_track.py
    --hand-source markers can follow the glove or the robot from the camera alone.
    Claude-Session: https://claude.ai/code/session_01TFr2PmfTwrKZZkFSHt6rPt
2026-10-24 Head-camera system: pipeline, positioner, deploy scripts, calibration, paper and rollout grid in one tree
    From the private experiment tree: the labelling chain (build_dataset, hand-eye, base-world fit, tile
    solver, head-pose and viewpoint-model scripts), the SO-101 camera positioner (kinematics, park,
    track), the evaluation tools (grid_analysis, val curves), the camera runbooks, the head-round
    validation curves and the final 25-scene rollout grid (trials.jsonl, placements, anecdotes).
    From the lerobot fork: eval_grid, evaluate_yam, camera_realign, record_yam_teleop and the YAM ZMQ
    host/client. From yam-umi: the paper (sections, figures, sources) as submitted to arXiv.
    Calibration files are t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
    [head_val_curves.csv, so101_new_calib.urdf, so101_old_calib.urdf]
2026-10-24 README: landing page for the head-camera system; calib inventory; robot-side procedure in scripts/README
    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
2026-10-25 STL: SO-101 positioner wrist-yaw housing and GoPro adapter
    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
    [finger_mount_to_gopro_mount.stl, wrist_yaw_motor_housing.stl]
2026-10-25 Camera mount STEP, XLeRobot horn adapter, arXiv link
    arducam_gopro_mount.step is the camera's own GoPro-pattern adapter.
    xlerobot_soft_fin_horn_adapter.stl is the horn bracket extracted from
    XLeRobot's hardware/SO101_soft_fin.stl (Apache-2.0), which sits between the
    positioner's wrist-yaw servo and finger_mount_to_gopro_mount.
    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
    [arducam_gopro_mount.step, xlerobot_soft_fin_horn_adapter.stl]
2026-10-25 STL: arducam_gopro_mount exported from the STEP
    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
    [arducam_gopro_mount.stl]
2026-10-26 media: rollout GIF from the head camera's own view (trial S25)
    Replaces the iPhone-shot rollout GIF, which had the operator in the
    background, with the positioner camera's recording of a mix_gHs3 success.
    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
2026-10-26 media: rollout GIF stacks the fixed camera and the head camera, synced from tick times
    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
2026-10-26 media: rollout GIF pairs the phone view with the head camera's view, synced from the trial log
    head_HH scene 1 is the only head-camera trial on the phone take; the
    offset comes from cross-correlating joint speed with the phone's motion
    energy and the head frames are placed by their tick times.
    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
2026-10-26 media: collection GIF ends at the drop, before the cable adjustment
    The previous cut applied the duration limit after the 1.5x speed-up, so
    the GIF ran ~13 s of source instead of 9.75 s and showed the cable being
    tidied after the episode. Window is now 19.75-28.4 s of the take (8.65 s,
    GIF ~5.8 s at 1.5x, 3.6 MB); the 1x clip matches.
    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
2026-10-31 docs: RAW_DATA.md describes the archived glove sessions and how to process them
    Streams per session (head, wrist fisheye, fixed camera), wall-clock
    sidecars, takes, how episode boundaries are marked and sliced, what is not
    archived, and the detection -> tile solve -> build chain with the calib
    files that apply to yam_glove5-8. Same file goes to the GCS bucket.
    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
2026-11-11 RAW_DATA: teleop head-cam sessions and the co-training LeRobot sets are in the bucket
    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
2026-11-11 poster: cut text by half, figure-led layout (draft 2)
    Claims as block titles, bullets instead of paragraphs, big numbers for
    the key results, rollout strip moved under the teaser, budget plot
    larger, body type scale 1.15 -> 1.3.
    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
2026-11-11 poster: teaser with the positioner as its own panel (draft 3)
    New fig/teaser_poster.jpg: (a) collector, (b) square crop of the head
    frame, (c) SO-101 positioner with the camera stacked above (d) the YAM,
    both from one iPhone rollout frame (336 s), so the robot arm is not
    hidden behind an inset. Paper teaser unchanged.
    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
2026-11-11 poster: rollout grid, retitled blocks, collection moved right (draft 5)
    Four rollouts from the fixed camera in a 2x2 grid: placement 15 head
    camera vs wrist UMI (drop mid-carry), placement 16 48 teleop alone vs
    48 + 194 glove. Top block retitled to say what the one camera does.
    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
2026-11-11 poster: motivation beside the photos, three columns below (draft 6)
    Why a head camera only | photos; then Label accuracy, Collection,
    Deployment; then the rollout grid (three moments per row). Limits back
    in the right column.
    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
2026-11-11 poster: one placement from each policy's own camera, three rows (draft 9)
    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
2026-11-11 poster: rollout strip on placement 23, wrist row from arm 8 (draft 11)
    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
2026-11-11 poster: rollout rows at one scale, seven frames each (draft 12)
    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
2026-11-11 poster: square-cropped rollout rows, twelve frames each, heavier text outlines (draft 13)
    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
2026-11-11 poster: fold label-table annotations into the head-camera column (draft 17)
    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
2026-11-11 poster: budget curve from the head-label chain only (draft 19)
    The paper figure overlays the encoder chain, scored on encoder targets,
    which invites reading the solid-vs-dashed offset as a label comparison.
    The poster plots one chain, with and without the glove set.
    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
2026-11-11 docs: source manifest for pilot_glove_HHs3 (session, take, marked episode per dataset episode)
    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
    [pilot_glove_HHs3_sources.csv]
2026-11-11 poster: deployment block says no wrist camera is needed (draft 33)
    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
2026-11-11 media: demo-table loop video (collection, labelled head frame, deployment, three policies on one placement)
    106 s, 1920x1080, no audio, built by media/make_demo_loop.py from the phone
    originals in yam-umi, the yam_glove6 head stream, media/head-rollout-clip.mp4
    and the placement-23 grid rollouts.
    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
2026-11-11 media: demo loop reframed for the device track (YAM-UMI), grip-force indicator as the next step
    156 s: title, the glove hardware, the original fixed-camera + fisheye labelling
    (from the YAM-UMI video), bridge to the head camera, the four head-cam segments,
    the spring glove's slits opening under a squeeze (zoom follows the row via
    squeeze_read; segment skipped when the spring files are absent), end card with
    both repos' QR codes.
    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
2026-11-11 media: demo loop cut to episode time (128 s)
    Phone collection: the four demonstrations only, resets cut. Head-camera
    segment: the reset between episodes 38 and 39 removed. YAM-UMI excerpt: one
    demonstration then the labels. Deployment clip: first 2 s dropped. Three-policy
    comparison: stops 8 s after the two short trials end, fixed camera marked cut.
    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
2026-11-11 media: demo loop with a jug lift before the spring readout; spec rows updated (135 s)
    Spring segment opens with the phone clip of the spring glove lifting a gallon jug by
    its handle (second lift of the take, 1x) with the slit row cropped at rest and under
    load, then the head-camera block squeeze as before. Hardware specs: strength 2 kg,
    dexterity notes the spring variant's narrower throw, labels add squeeze force on the
    spring variant; spec rows now wrap.
    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
2026-11-11 media: demo loop, collection bullet notes the ablation-only wrist and fixed cameras
    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
2026-11-11 media: talk version as a split layout, summary panel beside cycling media
    --short now renders a navy summary panel (title, six bullets, links) that stays for the
    whole minute with the current clip's bullet highlighted, while the media crossfades on
    the left: hardware stills, the YAM-UMI labels split screen, two glove demonstrations,
    the labelled head frame, deployment at 3x, the three-policy placement, the jug lift and
    the block grasp with the slit gauge. No cards or header bars in this version.
    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
2026-11-11 media: head-camera labels clip cut by episode frame index
    The glove6 head stream ran at 26.3 fps while the mkv's nominal clock is 25 fps, so
    the 169-190 s cut landed on the reset before episode 38 and the skip removed the
    grasp. Episodes 38 and 39 are now selected by frame index from the marks and the
    _ts.json (frames 4474-4636 and 4805-4970), back to back; the talk version shows
    episode 39 alone.
    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
2026-11-11 media: the wrist fisheye is described as the ablation only
    The YAM-UMI excerpt's own banner credited the jaw width to the fisheye; it is covered
    with "ball -> pose, jaw tails -> width, one camera; the wrist fisheye is for the
    ablations only". Header, caption, title card and the talk panel bullet reworded the
    same way.
    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
2026-11-11 media: talk version shows the phone and head-camera views side by side; rollout counts
    In the talk layout the collection section now runs the phone view (1.6x) beside the
    head camera's labelled frame (episodes 38 and 39, 1x) with the legend drawn next to
    the frame, replacing the two consecutive sections. The rollout section is titled
    "Rollouts" with the grid counts: head camera on the positioner 20/25, wrist fisheye
    14/25, fixed camera 12/25 (rollout_logs/grid_20261016/trials.jsonl); the column bars
    of the comparison carry the same counts in both versions.
    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
2026-11-11 media: talk version reads the camera and gripper pose live, and the dataset's width label
    media/live_labels.py runs the pipeline's own solvers on the demo frames: the head-pose
    multi-tile PnP (scripts/head_pose_fast.py) for the camera in the tile world, and
    labels_lib.solve_body_pose with the glove's ball and base-cube bundles for the gripper,
    with the tool point from calib/eef_target_glove_yosub.json. The legend beside the head
    frame shows both poses in cm and degrees per frame, and the jaw-width row shows the
    label stored in pilot_glove_HHs3 for that frame (episodes 72 and 73, mapped by the
    mark's wall-clock span) as a closed-to-open bar. A per-frame geometric width is not
    solved: from the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
2026-11-11 media: talk version pairs the head frame with the session's fixed camera, frame for frame
    The phone take (2026-10-16) has no head-camera recording, so the view beside the head
    frame is now glove6's fixed camera over the table, selected by the same wall-clock
    spans (fixed frames 4472-4644 and 4803-4978 for head frames 4469-4641 and 4800-4975),
    so both panels show the same moment. The live legend sits below the two views.
    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
2026-11-11 media: talk version adds a 3D view of the camera and gripper in the tile world
    A schematic view from a fixed virtual viewpoint (media/live_labels.View3D): the tiles
    and a 10 cm grid, the head camera as a frustum, the gripper as the ball's body axes
    with the fingertip point and a jaw symbol opened by the width label, both with 3 s
    trails. It sits under the head frame with the live readout to its left.
    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
2026-11-11 media: spring segment as an explanation slide then one grasp with a live graph
    Part one: the jug lift from the phone at 0.5x beside the measured-vs-commanded context
    (the YAM-UMI paper's 0.246 commanded / 0.335 measured on the block) and the slit row at
    rest and under load. Part two: one block grasp of yam_glove9 at 0.5x, the head frame
    and the slit zoom side by side, three short points, and a live graph of the jaw
    aperture (0 at the block) and the slit displacement with a cursor and a contact marker.
    The segment lays itself out within the media width in the talk version.
    Claude-Session: https://claude.ai/code/session_01TFr2PmfTwrKZZk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
2026-11-11 media: talk version under 60 s; jug clip as lift then set-down at 0.7x
    The paired-camera section shows episode 39 alone in the talk version (the fixed camera
    keeps step). The jug slide plays 8.6-10.6 s of the take (approach, grasp, lift: the
    slits go dark to white) and then 12.0-13.5 s (set-down and release: white to dark) at
    0.7x with a short crossfade between, tracked backward and forward from the known
    position at 9.0 s. Talk version 56 s, table loop 132 s.
    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
2026-11-11 media: table loop takes the two-camera section with the live readout and the 3D view
    The phone collection section is dropped from the table loop; its labels section is now
    the talk version's composition laid out for the full frame under the header: the fixed
    camera and the head camera of both glove6 episodes side by side, the camera and
    gripper pose solved live, the dataset's width label and the 3D view. Sections renumbered.
    Table loop 110 s, talk version 56 s.
    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
2026-11-11 media: one panel layout for both loops, QR codes always on screen
    The table loop uses the talk version's layout: the navy panel with the title, D10, the
    six section bullets (the current one highlighted), both repos' QR codes and the links,
    beside the media. The title, bridge and end cards and the header bars are gone; --short
    now only shortens the cuts. Table loop 97 s, talk version 57 s.
    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
2026-11-13 Back-marker holders: mirrored pair with M2 screw mount for YAM-UMI plate_v7
    Exported from the yam_umi Onshape assembly (2026-11-12). The STEP now holds
    the left and right bodies; the STLs are tessellated from it at 0.05 mm.
    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
    [gripper_back_marker_holder.step, gripper_back_marker_holder_left.stl, gripper_back_marker_holder_right.stl]
2026-11-13 README: spring glove coming soon
    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
